dyerbm/NixieTubeClock/Project Outputs for NixieClock_Clock_IN-14/NixieClock_Clock_IN-14.xlsx

Line # | Name | Description | Designator | Quantity | Manufacturer 1 | Manufacturer Part Number 1 | Manufacturer Lifecycle 1 | Supplier 1 | Supplier Part Number 1 | Supplier Unit Price 1 | Supplier Subtotal 1
 | 0.1uF | Capacitor | C1, C2, C3, C4, C5, C6 | 6 | KEMET | C0603C104K5RACTU | Volume Production | Digi-Key | 399-5089-6-ND | 0.15211 | 0.91265
 | WS2812B | Raspberry Pi HAT _40 pin_ Wheeled Robotics Kit | D1, D2, D3, D4, D5, D6 | 6
 | in-14-2 |  | NX1, NX2, NX3, NX4, NX5, NX6 | 6
 | Header 7 | Header, 7-Pin | P1 | 1 | Amphenol FCI | 68001-407HLF | Volume Production | Digi-Key | 609-68001-407HLF-ND | 0.469 | 0.469
 | Res1 | Resistor | R1, R2, R3, R4, R5, R6 | 6 | Vishay | CRCW0603-20K0FKEA | Volume Production | Digi-Key | 541-20.0KHCT-ND | 0.03929 | 0.39295
 | HV5623 |  | U1, U2 | 2 | Microchip Supertex | HV5623K7-G | Volume Production | Digi-Key | HV5623K7-G-ND | 9.65 | 19.29
