dyerbm/NixieTubeClock/Project Outputs for NixieClock_Controller/NixieClock_Controller.xlsx

Line # | Name | Description | Designator | Quantity | Manufacturer 1 | Manufacturer Part Number 1 | Manufacturer Lifecycle 1 | Supplier 1 | Supplier Part Number 1 | Supplier Unit Price 1 | Supplier Subtotal 1
 | Battery | Multicell Battery | BT1 | 1 | Harwin | S8411-45R | Volume Production | Digi-Key | 952-1745-1-ND | 1.66 | 1.66
 | 1000pF | Capacitor | C1 | 1 | KEMET | C0805C102K1RACTU | Volume Production | Digi-Key | 399-1148-1-ND | 0.21549 | 0.21549
 | 220uF | Polarized Capacitor (Radial) | C2 | 1 | Nichicon | UUR1C221MCL6GS | Volume Production | Digi-Key | 493-6214-1-ND | 0.43097 | 0.43097
 | 100pF | Capacitor | C3 | 1 | KEMET | C0805C101J1GACTU | Volume Production | Digi-Key | 399-1123-1-ND | 0.13943 | 0.13943
 | 2.2uF | Polarized Capacitor (Radial) | C4 | 1 | Nichicon | UUB2G2R2MNL1GS | Volume Production | Digi-Key | 493-9969-1-ND
 | 10uF | Capacitor | C5, C11 | 2 | KEMET | C0805C106K8PACTU | Volume Production | Digi-Key | 399-4925-1-ND | 0.17746 | 0.35492
 | 0.1uF | Capacitor | C6, C7, C8, C9, C10 | 5 | KEMET | C0805C104M5UACTU | Volume Production | Digi-Key | 399-1176-1-ND | 0.22816 | 1.14
 | 22uF | Capacitor | C12 | 1 | Kyocera AVX | 08056D226MAT2A | Volume Production | Digi-Key | 478-3647-1-ND | 0.84927 | 0.84927
 | BYG23T-M3 | Default Diode | D1 | 1 | Vishay Semiconductors | BYG23T-M3/TR | Volume Production | Digi-Key | BYG23T-M3/CT-ND
 | WS2812B | Raspberry Pi HAT _40 pin_ Wheeled Robotics Kit | D2, D3, D4 | 3 | Adafruit Industries | 1655 | Volume Production | Digi-Key | 1528-1104-ND
 | 100uH | Inductor | L1 | 1 | Wurth Electronics | 74477020 | Volume Production | Digi-Key | 732-1235-1-ND
 | BarrelConnector5.5 |  | P1 | 1 | CUI | PJ-037A | Volume Production | Digi-Key | CP-037A-ND
 | Header 7 | Header, 7-Pin | P2 | 1 | Sullins | PPTC071LFBN-RC | Volume Production | Digi-Key | S7005-ND | 0.74787 | 0.74787
 | Header 5 | Header, 5-Pin | P3 | 1 | Adam Equipment | 2PH1-05-UA
 | IRF740 | N-Channel MOSFET | Q1 | 1 | Vishay | IRF740SPBF | Not Recommended for New Design | Digi-Key | IRF740SPBF-ND
 | 47K | Resistor | R1 | 1 | Vishay | CRCW0805-47K0FKEA | Volume Production | Digi-Key | 541-47.0KCCT-ND | 0.12676 | 0.12676
 | 150K | Resistor | R2 | 1 | Panasonic | ERJ-6ENF1503V | Volume Production | Digi-Key | P150KCCT-ND | 0.12676 | 0.12676
 | 499K | Resistor | R3 | 1 | Vishay | CRCW0805499KFKEA | Volume Production | Digi-Key | 541-499KCCT-ND | 0.12676 | 0.12676
 | 6.98K | Resistor | R4 | 1 | Vishay | CRCW08056K98FKEA | Volume Production | Digi-Key | 541-6.98KCCT-ND | 0.12676 | 0.12676
 | 0.5R | Resistor | R5 | 1 | Stackpole Electronics | CSR0805FKR500 | Volume Production | Digi-Key | CSR0805FKR500CT-ND | 0.32957 | 0.32957
 | 4.7K | Resistor | R6, R7, R12 | 3 | Vishay | CRCW0805-4K70FKEA | Volume Production | Digi-Key | 541-4.70KCCT-ND | 0.12676 | 0.38027
 | SW-PB | Switch | S1, S2, S3 | 3 | E-Switch | TL1105WF160Q | Volume Production | Digi-Key | EG1835-ND | 0.40562 | 1.22
 | UC3843 |  | U1 | 1 | Texas Instruments | UC3843D8 | Volume Production | Digi-Key | 296-11287-5-ND | 1.77 | 1.77
 | attiny1617 |  | U3 | 1 | Microchip | ATTINY1617-MN |  | Digi-Key | ATTINY1617-MN-ND | 1.17 | 1.17
 | DS3231MZ+ | +/-5ppm, I2C Real-Time Clock with Internal MEMs Resonator and SRAM, 8-Pin SO, -40 to 85 degC, Pb-Free | U4 | 1 | Maxim | DS3231MZ+ | Volume Production | Digi-Key | DS3231MZ+-ND
 | Volt Reg | Voltage Regulator | VR1 | 1 | STMicroelectronics | LD1117S50CTR | Volume Production | Digi-Key | 497-1243-1-ND | 0.5197 | 0.5197
