dyerbm/NixieTubeClock/Clock_PartsList.xlsx

Digi-Key Part Number | Customer Reference | Quantity
1568-1800-ND | D1-6 | 6
RR08P15.0KDCT-ND | R7-12 | 6
RNCP0805FTD20K0CT-ND | R1-6 | 6
732-5309-ND | P1 | 1
