dyerbm/NixieTubeClock/Depricated/Clock_PartsList.xlsx

Digi-Key Part Number | Customer Reference | Quantity
160-1827-1-ND | D1-12 | 12
RR08P100DCT-ND | R1-12 | 12
RNCP0805FTD20K0CT-ND | R13-18 | 6
