dyerbm/NixieTubeClock/Depricated/Controller_PartsList.xlsx

Digi-Key Part Number | Customer Reference | Quantity
1276-6455-1-ND | C2, C6 | 2
1276-1286-1-ND | C3,C4 | 2
445-13454-1-ND | C5 | 1
PCF1412CT-ND | C7 | 1
ES2F-E3/52TGICT-ND | D1 | 1
IRF644SPBF-ND | Q1 | 1
MMBTA92LT1GOSCT-ND | Q2-4 | 3
P50MCT-ND | RSENSE | 1
PT1.5MXCT-ND | R1 | 1
490-6996-1-ND | R2 | 1
541-3976-1-ND | R3 | 1
RMCF0805FT10K0CT-ND | R4,R6,R8 | 3
RMCF0805FT300KCT-ND | R5,R7,R9 | 3
A130138CT-ND | R10,R11 | 2
732-1248-1-ND | L1 | 1
952-1745-1-ND | BT1 | 1
MAX1771CSA+CT-ND | IC1 | 1
296-12010-1-ND | IC2 | 1
HV5122PG-G-ND | IC3 | 1
945-2409-5-ND | IC4 | 1
CP-037A-ND | IC5 | 1
DS3231MZ+-ND | IC6 | 1
1528-1438-ND | IC7 | 1
486-3471-ND | B1-3 | 3
