dyerbm/NixieTubeClock/Depricated/NixieClockRev2/PartsList.xlsx

Digi-Key Part Number | Customer Reference | Quantity
945-2409-5-ND | P1 | 1
1276-6455-1-ND | C2, C6 | 2
1276-1286-1-ND | C3,C4 | 2
PCF1412CT-ND | C7 | 1
ES2F-E3/52TGICT-ND | D1 | 1
541-3976-1-ND | R3 | 1
PT1.5MXCT-ND | R1 | 1
P50MCT-ND | RSENSE | 1
IRF644PBF-ND | Q1 | 1
490-6996-1-ND | R2 | 1
PCE3432CT-ND | C5 | 1
MAX1771CSA+CT-ND | IC1 | 1
CP-037A-ND | P2 | 1
495-2703-1-ND | L1 | 1
1727-5820-1-ND | T1-30 | 30
A130138CT-ND | R4,R5 | 2
DS3231MZ+-ND | IC3 | 1
609-3263-ND | Header1 | 1
952-1745-1-ND | BT1 | 1
1528-1438-ND | IC2 | 1
RNCP0805FTD20K0CT-ND | R6-11 | 6
