dyerbm/NixieTubeClock/SEPIC_Spice.asc

C1: cap; 22µ; V=16 Irms=3 Rser=3m
C2: cap; 1µ; V=250 Irms=2 Rser=8m
C3: cap; 4.7µ
CC1: cap; 1n
CC2: cap; 50p
Cin: cap; 22µ; V=16 Rser=10m
CSS: cap; 100n
D1: diode
L1: ind; 0.000047; Ipk=3.2 Rser=0.145
L2: ind; 0.000047; Ipk=0.39 Rser=0.871
R1: res; 1.8k; tol=1 pwr=0.25
R2: res; 200k; tol=1 pwr=0.25
R3: res; 27k
R4: res; 12k
R5: res; 9k
RC: res; 10k
RSense: res; 0.05; tol=0.1 pwr=0.1
RT: res; 16.5k
U1: LT3757A
U2: TPN2010FNH_G0_00
V1: voltage; 5
Named nets: 0, FBX
.tran 1
