dyerbm/NixieTubeClock/(list of files, drawings)

Other design files:
BoostConverter.SchDoc
Clock.PcbDoc
Clock.SchDoc
Controller.PcbDoc
Controller.SchDoc
CustomComponentsLibrary.PcbLib
CustomComponentsLibrary.SchLib
Depricated/Clock.SchDoc
Depricated/ClockBoard.PcbDoc
Depricated/Controller.SchDoc
Depricated/ControllerBoard.PcbDoc
Depricated/Imported nixie-tubes.PrjPcb/nixie-tubes.PCBLIB
Depricated/Imported nixie-tubes.PrjPcb/nixie-tubes.PrjPcb
Depricated/Imported nixie-tubes.PrjPcb/nixie-tubes.SCHLIB
Depricated/Imported nixie-tubes.PrjPcb/nixie-tubes/nixie-tubes.PCBLIB
Depricated/Imported nixie-tubes.PrjPcb/nixie-tubes/nixie-tubes.SCHLIB
Depricated/NixieClock_Clock_R2-1.PrjPCB
Depricated/NixieClock_Controller_R2-1.PrjPCB
Depricated/NixieClockRev2/Digits.SchDoc
Depricated/NixieClockRev2/NixieClockR2.PrjPCB
Depricated/NixieClockRev2/Power.SchDoc
LTST-C19HE1WT/Imported LTST-C19HE1WT.lia/LTST-C19HE1WT.PcbLib
LTST-C19HE1WT/Imported LTST-C19HE1WT.lia/LTST-C19HE1WT.SchLib
NixieClock.PcbDoc
NixieClock_Clock_IN-8-2.PrjPCB
NixieClock_Clock_IN-14.PrjPCB
NixieClock_Controller.PrjPCB
