dyerbm/NixieTubeClock/(commit log)

2019-04-05 Nixie Clock using in-18s
    Revision of nixie tube clock using in-18s
    [Digits.SchDoc, NixieClockR2.PcbDoc, NixieClockR2.PrjPCB, PartsList.xlsx, Power.SchDoc]
2020-05-04 Mass commit, updated boards and project, depricated all old files
    [Clock.PcbDoc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]
2020-05-04 Added version number to the boards
    [Clock.PcbDoc, Controller.PcbDoc]
2020-05-04 Start of file renaming
    [NixieClock_Clock_IN-14.PrjPCB, NixieClock_Controller_R2-1.PrjPCB]
2020-05-04 More file changes
    [NixieClock.PcbDoc, NixieClock_Controller.PrjPCB, NixieClock_Controller_R2-1.PrjPCB]
2020-05-04 Even more changes
    [NixieClock_Clock_IN-14.PrjPCB]
2020-05-08 made fabrication files
    [Clock.PcbDoc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]
2020-05-28 Made fabrication outputs
    [Clock.PcbDoc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]
2020-06-18 Added part links to controller, created BOM for controller
    [Controller.SchDoc, Controller_PartsList.xlsx, NixieClock_Controller.PrjPCB]
2020-06-18 Small change to BOM
    [NixieClock_Controller.xlsx]
2020-10-24 Redesigned Boost converter
    [BoostConverter.SchDoc, Controller.SchDoc]
2020-10-24 Cleaned up controller, added new HV5622PJ (WIP)
    [BoostConverter.SchDoc, Controller.SchDoc]
2020-10-26 Most new components are in schematic WIP
    [BoostConverter.SchDoc, Controller.SchDoc]
2020-10-31 Finished schematic (WIP)
    [Controller.SchDoc]
2020-10-31 Re-routed controller, almost ready for fab
    [BoostConverter.SchDoc, Controller.PcbDoc, Controller.SchDoc]
2020-10-31 Fixed HV5623, needs BOM, ready for fab
    [Controller.PcbDoc, Controller.SchDoc, NixieClock_Controller.PrjPCB]
2020-11-01 Finished BOM, ready for fab
    [Controller.SchDoc]
2020-11-01 Shifted Buttons
    [Controller.PcbDoc]
2020-11-01 Generate Fab outputs
    [NixieClock_Controller.PrjPCB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]
2020-11-28 Controller board error, updated resistor value for UPDI programming
2020-12-17 More changes, need to re-route
    [Clock.PcbDoc, Clock.SchDoc, Controller.PcbDoc, Controller.SchDoc, NixieClock_Clock_IN-14.PrjPCB]
2021-01-08 Updated BOM for new rev
    [Clock.PcbDoc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]
